Mohamad548/app-ios/web-demo/kit/backgrounds/dark-aurora.webp

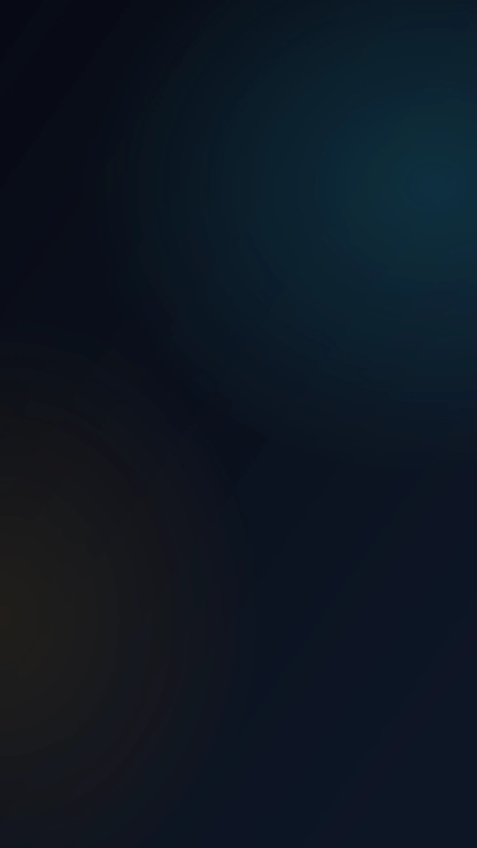
web-demo/kit/backgrounds/dark-aurora.webp
