Mohamad548/app-ios/web-demo/kit/backgrounds/light-aurora.webp

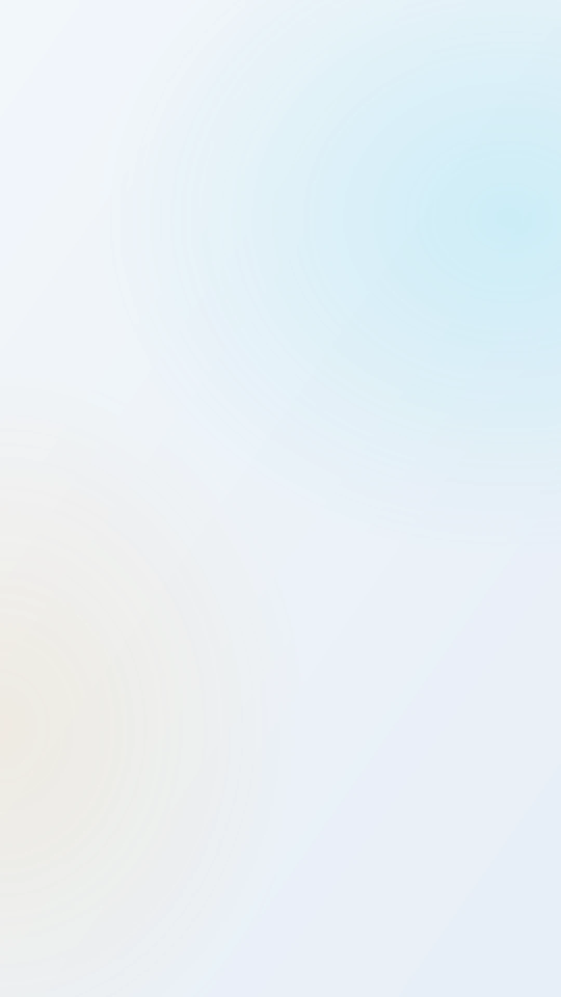
web-demo/kit/backgrounds/light-aurora.webp
