Mohamad548/app-ios/web-demo/kit/brand/app-mark.png

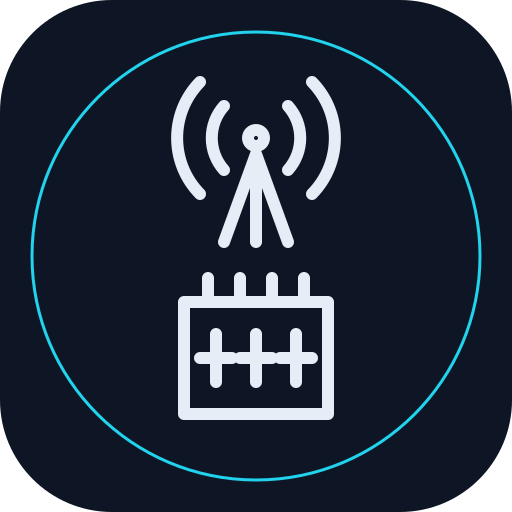
web-demo/kit/brand/app-mark.png
