Mohamad548/app-ios/web-demo/kit/brand/luminous-ring.png

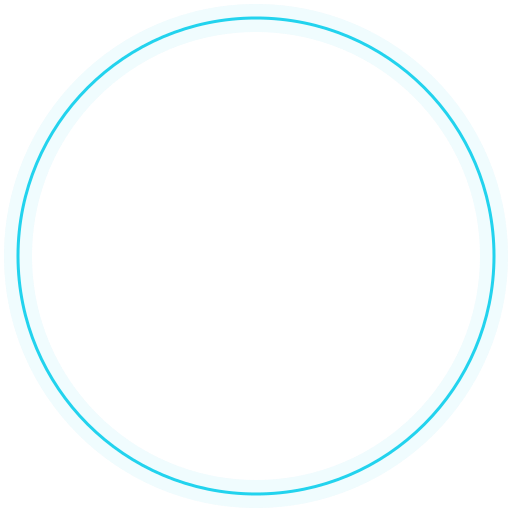
web-demo/kit/brand/luminous-ring.png
