Mohamad548/app-ios/web-demo/kit/brand/relay-glyph.png

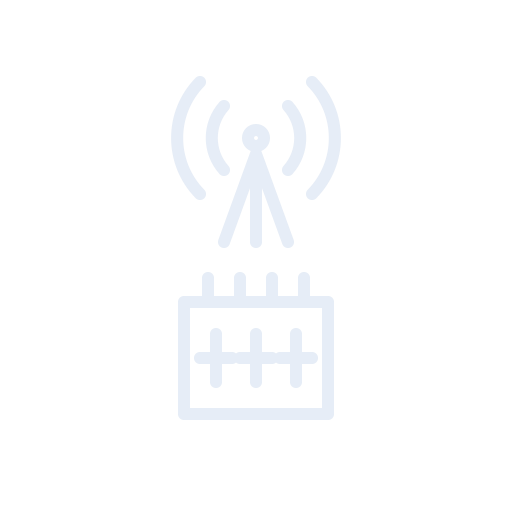
web-demo/kit/brand/relay-glyph.png
