Mohamad548/app-ios/web-demo/kit/fans/png/dark/fan-awaiting.png

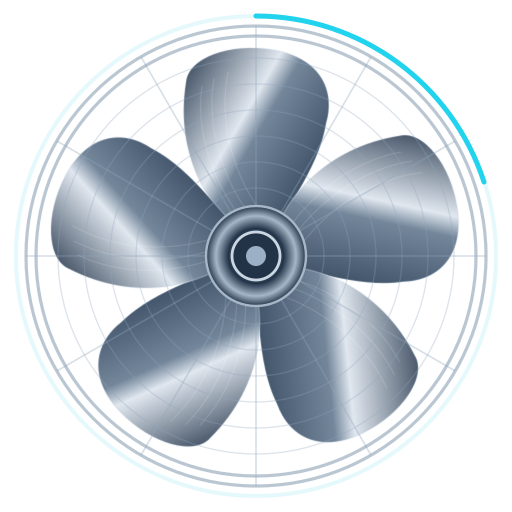
web-demo/kit/fans/png/dark/fan-awaiting.png
