Mohamad548/app-ios/web-demo/kit/fans/webp/layers/dark/hub-256.webp

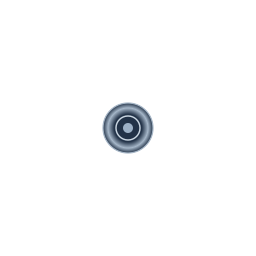
web-demo/kit/fans/webp/layers/dark/hub-256.webp
