Mohamad548/app-ios/web-demo/kit/fans/webp/layers/dark/rotor-off-256.webp

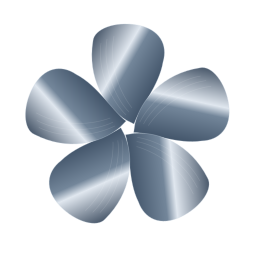
web-demo/kit/fans/webp/layers/dark/rotor-off-256.webp
