Mohamad548/app-ios/web-demo/kit/fans/webp/layers/light/cage-256.webp

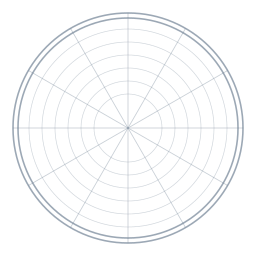
web-demo/kit/fans/webp/layers/light/cage-256.webp
