Mohamad548/app-ios/web-demo/kit/fans/webp/layers/progress-arc-256.webp

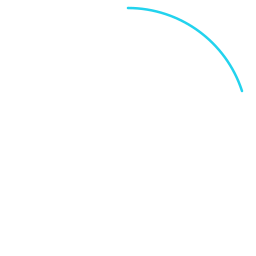
web-demo/kit/fans/webp/layers/progress-arc-256.webp
