Mohamad548/app-ios/web-demo/kit/illustrations/empty-log.png

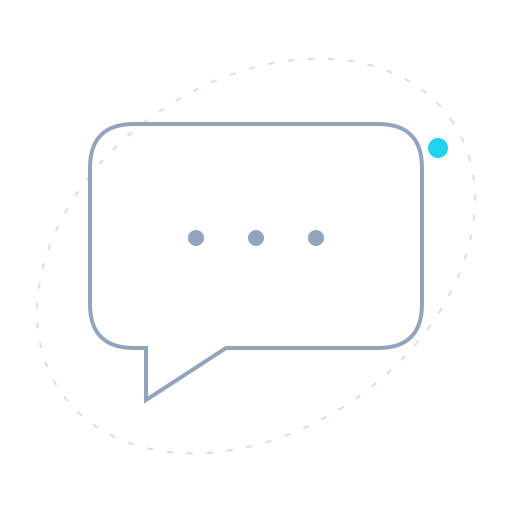
web-demo/kit/illustrations/empty-log.png
