Mohamad548/app-ios/web-demo/kit/components/webp/dark/bottom-sheet-3x.webp

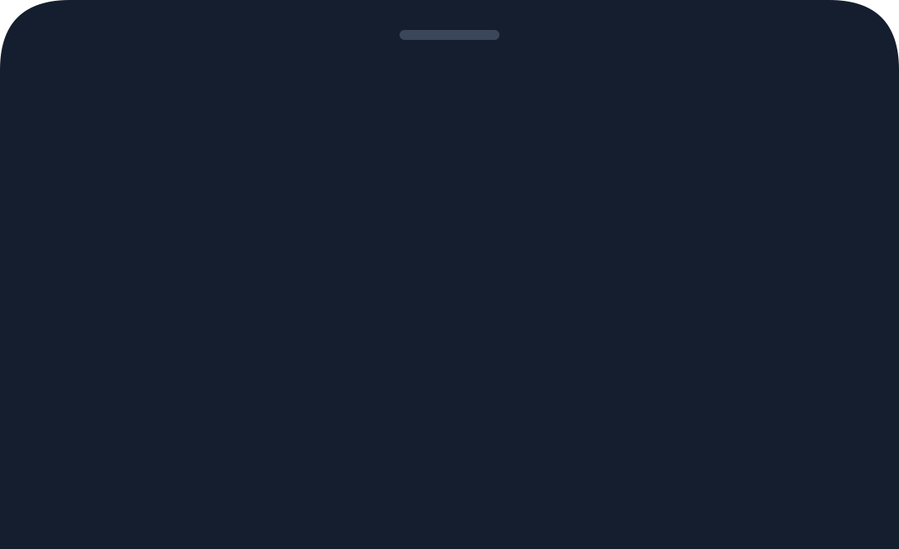
web-demo/kit/components/webp/dark/bottom-sheet-3x.webp
