Mohamad548/app-ios/web-demo/kit/components/webp/dark/card-disabled-3x.webp

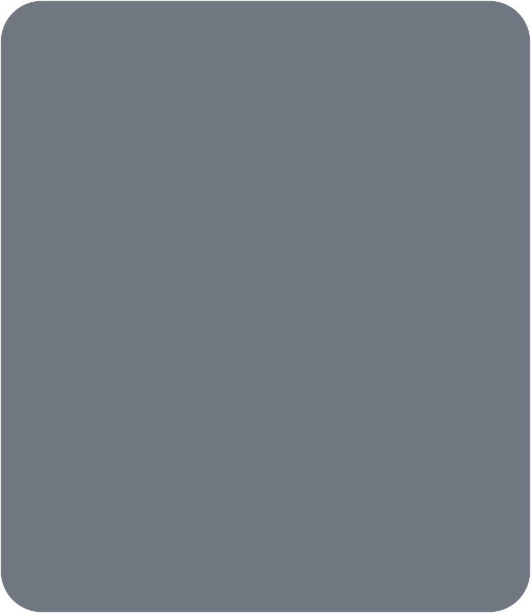
web-demo/kit/components/webp/dark/card-disabled-3x.webp
