Mohamad548/app-ios/web-demo/kit/components/webp/dark/card-pressed-3x.webp

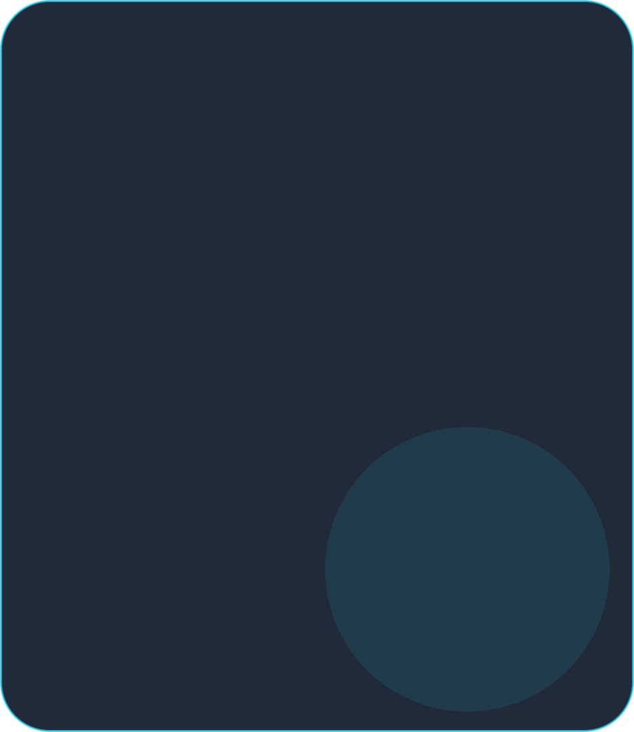
web-demo/kit/components/webp/dark/card-pressed-3x.webp
