Mohamad548/app-ios/web-demo/kit/components/webp/light/card-disabled-3x.webp

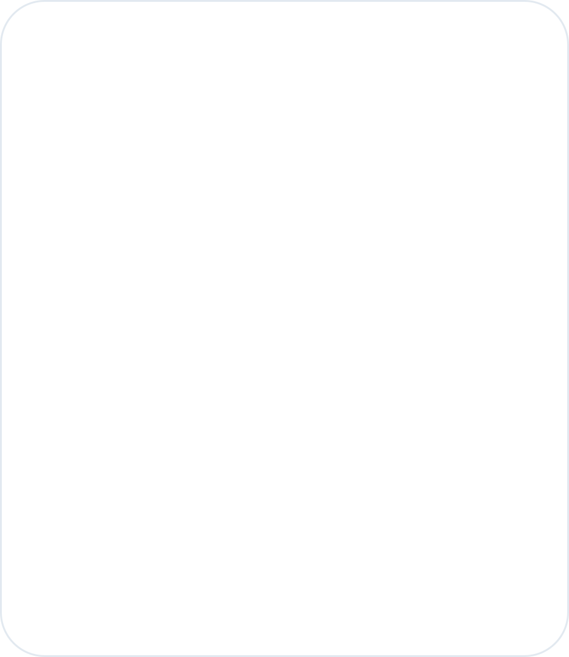
web-demo/kit/components/webp/light/card-disabled-3x.webp
